SeermebeA/Albaricoque/Multimedia/img/Screenshot at Nov 30 00-08-27.png

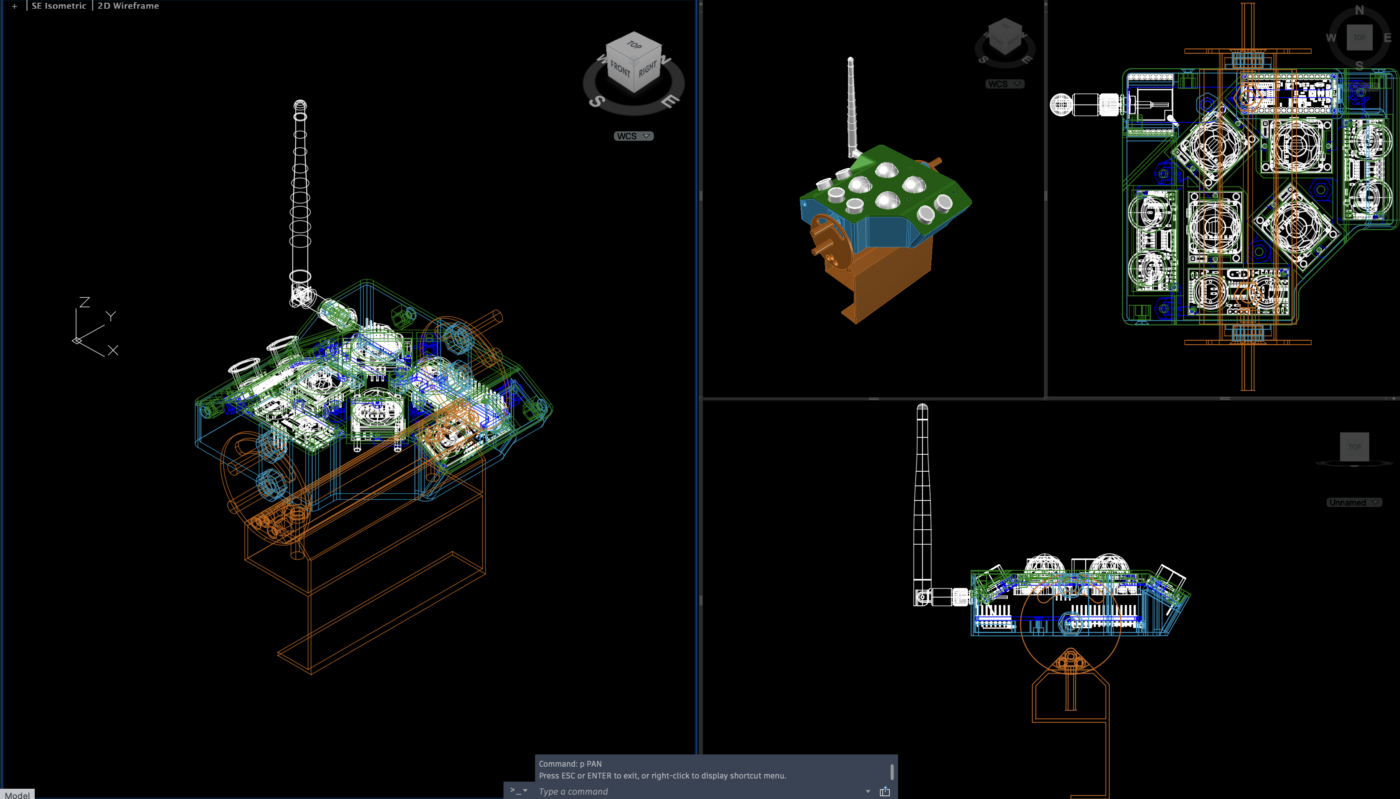
Multimedia/img/Screenshot at Nov 30 00-08-27.png
