SeermebeA/Albaricoque/Multimedia/img/Screenshot at Nov 30 00-12-04.png

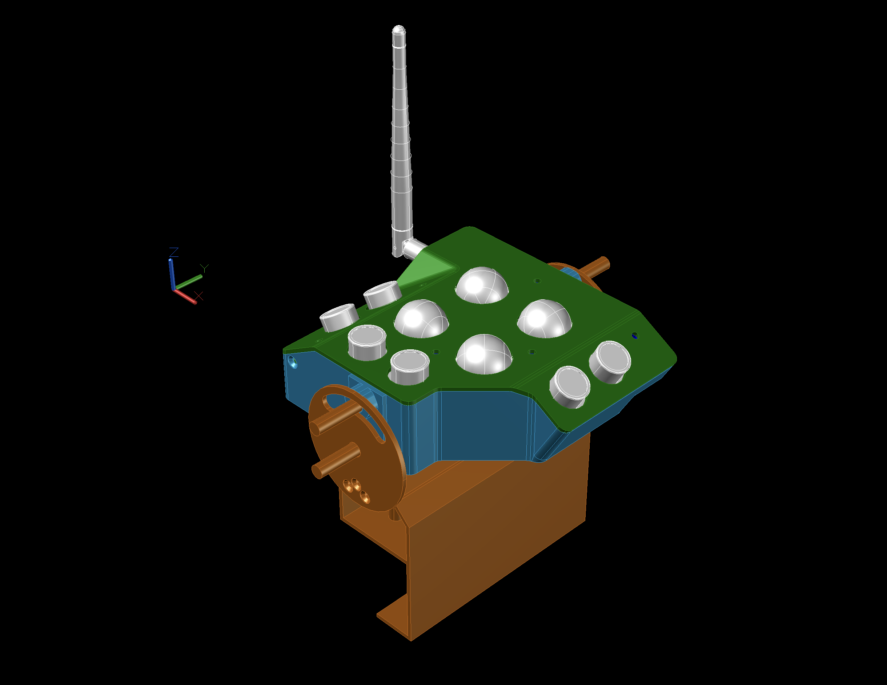
Multimedia/img/Screenshot at Nov 30 00-12-04.png
