SeermebeA/Albaricoque/(commit log)

2025-11-30 feat(core): initialize project structure, sensor-fusion pipeline docs, and baseline field logs
    - Add initial repository structure for firmware (/firmware), mechanical design (/mechanical), hardware specs (/hardware), and documentation (/docs).
    - Include full README with architectural overview (PIR Δt sequencing + HC-SR04 burst median/variance + apparent-height geometry).
    - Document feature-extraction model pathway for Edge Impulse (INT8 inference on Arduino Nano 33 BLE Sense Rev2).
    - Add raw field-test logs (25 samples) with PIR activations, ultrasonic tri-channel readings, and derived Delta(cm) features.
    - Provide preliminary statistical analysis (sampling period ~277 ms, multipath artifac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
2025-11-30 feat(core): initialize project structure, sensor-fusion pipeline docs, and baseline field logs - Add initial repository structure for firmware (/firmware), mechanical design (/mechanical), hardware s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
    [Animal.csv, Solo.csv, Walk1.csv, Walk2.csv, Walk3.csv, Walk4.csv]
2025-11-30 docs(readme): add class definitions and prototype image
    - Added detailed definitions for all Edge Impulse classes (Animal, Solo, Walk1–Walk4), including distance-based segmentation (30 cm intervals) for human walking categories.
    - Updated documentation to improve clarity for hackathon submission and dataset interpretation.
