SeermebeA/Albaricoque/Multimedia/img/IMG_A4747724-B7D7-48E8-AA30-DD9A2AE306A3.JPG

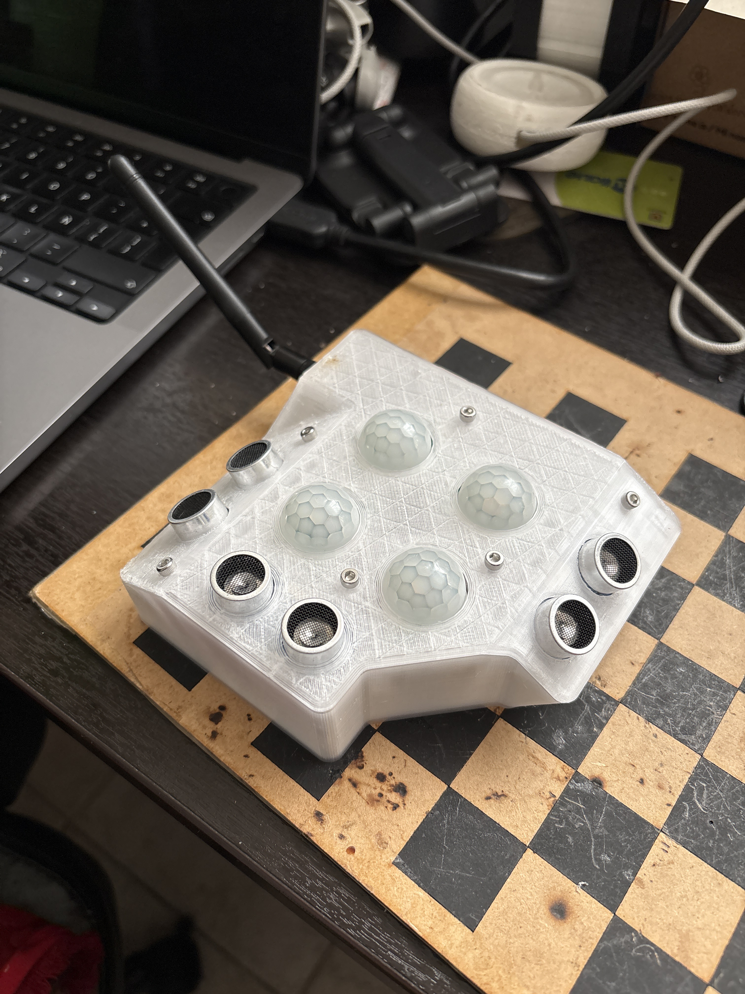
Multimedia/img/IMG_A4747724-B7D7-48E8-AA30-DD9A2AE306A3.JPG
